nguyenchitu2005-jpg/KhoaBaoMat/docs/HuongDan_Slide_CongNghe_VanTay_KhuonMat.docx

# Hướng dẫn làm slide

Giới thiệu công nghệ chính của chức năng mở khoá bằng vân tay và khuôn mặt

Bản hướng dẫn này đi từ slide đầu tới slide cuối để giới thiệu 5 công nghệ chính làm nên hai chức năng mở khoá bằng vân tay và bằng khuôn mặt của khoá cửa thông minh. Mỗi slide gồm: mục đích, nội dung nên đưa lên, hình minh hoạ, lời nói gợi ý.

# Phần 1. Chuẩn bị trước khi làm slide

## 1.1. Năm công nghệ sẽ giới thiệu

Chức năng | Công nghệ | Vai trò trong dự án
Vân tay | Cảm biến vân tay quang học AS608 | Chụp ảnh, trích đặc trưng, lưu mẫu (tối đa 32) và so khớp ngay trong cảm biến
Vân tay | Adafruit Fingerprint Sensor Library 2.1.4 | Thư viện để ESP32 điều khiển AS608 qua UART
Khuôn mặt | Google ML Kit Face Detection | Tìm khuôn mặt và vị trí mắt; đo xác suất mắt mở để chống ảnh giả (bắt nháy mắt)
Khuôn mặt | Mô hình FaceNet-512 | Biến ảnh khuôn mặt thành vector 512 chiều để so khớp
Khuôn mặt | TensorFlow Lite | Chạy FaceNet-512 ngay trên điện thoại, không cần internet

## 1.2. Khung bài

- Tổng cộng 12 slide, khoảng 10–12 phút trình bày cộng 3–5 phút hỏi đáp.
- Thứ tự: mở đầu (3 slide) → nhóm vân tay (3 slide) → nhóm khuôn mặt (4 slide) → tổng kết và hỏi đáp (2 slide).
- Mỗi công nghệ trả lời đủ 3 câu: Nó là gì? Dùng để làm gì trong dự án? Hoạt động thế nào?

## 1.3. Quy tắc trình bày slide

- Mỗi slide một ý chính, tối đa 5–6 dòng chữ, cỡ chữ nội dung từ 24pt, tiêu đề từ 32pt.
- Dùng một mẫu (template) thống nhất cho cả bài: cùng phông chữ, cùng vị trí tiêu đề, cùng kiểu đánh số.
- Ưu tiên sơ đồ, lưu đồ, ảnh thật phần cứng và ảnh chụp màn hình app thay cho đoạn văn dài.
- Chữ trên slide là từ khoá; phần giải thích để trong lời nói (ghi vào phần Notes của slide).
- Ghi tên công nghệ đúng chính tả và đầy đủ ở lần nhắc đầu tiên, ví dụ "Google ML Kit Face Detection", các lần sau có thể gọi tắt "ML Kit".
- Đánh số trang cho mọi slide (trừ slide tiêu đề).

# Phần 2. Nội dung từng slide

### Nhóm mở đầu

## Slide 1. Tiêu đề

Mục đích: Giới thiệu đề tài và nhóm.

Nội dung đưa lên slide:

- Tên đề tài: Khoá cửa thông minh – mở khoá bằng vân tay và khuôn mặt
- Tên thành viên, lớp, giảng viên hướng dẫn
- Ngày trình bày

Hình minh hoạ: Một ảnh thật của khoá đã lắp hoàn chỉnh.

Lời thuyết trình gợi ý: "Nhóm em xin trình bày đề tài khoá cửa thông minh, tập trung vào các công nghệ giúp mở khoá bằng vân tay và bằng khuôn mặt."

## Slide 2. Mục tiêu và năm công nghệ chính

Mục đích: Cho người nghe thấy ngay toàn cảnh: hai chức năng, năm công nghệ.

Nội dung đưa lên slide:

- Mục tiêu: mở cửa bằng sinh trắc học, không cần chìa khoá
- Vân tay: cảm biến AS608 + thư viện Adafruit Fingerprint
- Khuôn mặt: Google ML Kit + FaceNet-512 + TensorFlow Lite

Hình minh hoạ: Bảng ở mục 1.1 rút gọn còn 2 cột: Công nghệ – Vai trò.

Lời thuyết trình gợi ý: "Để làm được hai chức năng này, nhóm dùng năm công nghệ: hai cho vân tay và ba cho khuôn mặt. Các slide sau sẽ giới thiệu lần lượt từng công nghệ."

## Slide 3. Công nghệ nằm ở đâu trong hệ thống

Mục đích: Chỉ rõ phần nào chạy trên khoá, phần nào chạy trên điện thoại.

Nội dung đưa lên slide:

- Trên khoá: ESP32 + cảm biến AS608 (thư viện Adafruit) → relay → chốt khoá
- Trên điện thoại: app Flutter dùng ML Kit, FaceNet-512, TensorFlow Lite
- Hai bên nói chuyện qua lệnh đã mã hoá

Hình minh hoạ: Sơ đồ khối 2 khung: "Khoá cửa" bên trái, "Điện thoại" bên phải, mũi tên lệnh mở ở giữa. Ghi tên từng công nghệ vào đúng khung.

Lời thuyết trình gợi ý: "Vân tay được xử lý ngay trên khoá. Khuôn mặt được xử lý trên điện thoại, khớp rồi điện thoại mới gửi lệnh mở cửa đã mã hoá cho khoá."

### Nhóm vân tay

## Slide 4. Cảm biến vân tay quang học AS608

Mục đích: Giới thiệu phần cứng nhận diện vân tay và nhấn mạnh việc nhận diện diễn ra ngay trong cảm biến.

Nội dung đưa lên slide:

- Là gì: mô-đun vân tay quang học có vi xử lý riêng
- Nguyên lý: đèn chiếu lên ngón tay đặt trên lăng kính, cảm biến ảnh chụp lại các đường vân
- Tự trích đặc trưng, lưu mẫu và so khớp bên trong mô-đun
- Trong dự án: lưu tối đa 32 vân tay; nối ESP32 qua UART 57.600 baud, nguồn 3,3V

Hình minh hoạ: Ảnh thật của mô-đun AS608 và một hình đơn giản minh hoạ ngón tay – lăng kính – camera.

Lời thuyết trình gợi ý: "AS608 không chỉ chụp ảnh vân tay. Bên trong nó có bộ xử lý riêng nên tự trích đặc trưng, tự lưu mẫu và tự so khớp. Mẫu vân tay vì vậy không bao giờ rời khỏi cảm biến."

Lưu ý: Số 32 là giới hạn do nhóm đặt trong dự án, không phải dung lượng tối đa của AS608.

## Slide 5. Thư viện Adafruit Fingerprint Sensor Library 2.1.4

Mục đích: Giải thích ESP32 "ra lệnh" cho cảm biến bằng cách nào.

Nội dung đưa lên slide:

- Là gì: thư viện mã nguồn mở của Adafruit cho Arduino/ESP32
- Chức năng: đóng gói giao thức UART của cảm biến thành các hàm dễ gọi
- Hàm chính: getImage (chụp), image2Tz (trích đặc trưng), createModel + storeModel (tạo và lưu mẫu), fingerSearch (tìm mẫu khớp), deleteModel (xoá)

Hình minh hoạ: Bảng 2 cột "Hàm – Ý nghĩa" như bảng bên dưới.

Lời thuyết trình gợi ý: "Nhờ thư viện Adafruit, ESP32 chỉ cần gọi vài hàm như chụp ảnh, trích đặc trưng, tìm mẫu; thư viện lo việc gửi và nhận gói tin với cảm biến qua cổng UART."

Hàm | Ý nghĩa | Dùng khi
getImage() | Chụp ảnh vân tay | Đăng ký và mở khoá
image2Tz() | Chuyển ảnh thành bộ đặc trưng | Đăng ký và mở khoá
createModel() | Ghép 2 lần chụp thành 1 mẫu | Đăng ký
storeModel(id) | Lưu mẫu vào vị trí ID | Đăng ký
fingerSearch() | Tìm mẫu khớp trong các mẫu đã lưu (1:N) | Mở khoá
deleteModel(id) | Xoá một mẫu | Xoá vân tay

## Slide 6. Vân tay hoạt động thế nào

Mục đích: Ghép hai công nghệ vân tay thành một quy trình hoàn chỉnh.

Nội dung đưa lên slide:

- Đăng ký: đặt tay lần 1 → nhấc tay → đặt tay lần 2 → ghép mẫu → lưu
- Mở khoá: cứ 300 ms kiểm tra → chụp → trích đặc trưng → tìm mẫu khớp
- Khớp: mở chốt 5 giây, ghi nhật ký; không khớp: đèn đỏ, còi báo

Hình minh hoạ: Hai lưu đồ ngắn đặt cạnh nhau: "Đăng ký" và "Mở khoá".

Lời thuyết trình gợi ý: "Khi đăng ký, ngón tay được chụp hai lần để mẫu ổn định. Khi mở khoá, cảm biến so ngón tay với mọi mẫu đã lưu; khớp là chốt mở trong 5 giây rồi tự khoá lại."

### Nhóm khuôn mặt

## Slide 7. Google ML Kit Face Detection

Mục đích: Giới thiệu công cụ phát hiện khuôn mặt và phân biệt rõ "phát hiện" với "nhận dạng".

Nội dung đưa lên slide:

- Là gì: bộ công cụ học máy của Google cho điện thoại, chạy ngay trên máy
- Chức năng: tìm khuôn mặt trong ảnh, vị trí hai mắt, góc quay đầu, xác suất mắt mở
- Dùng cho 2 việc: chống ảnh giả (bắt nháy mắt) và chuẩn bị ảnh mặt cho FaceNet
- ML Kit chỉ PHÁT HIỆN có khuôn mặt, không biết đó là ai

Hình minh hoạ: Ảnh chụp màn hình app lúc quét mặt, có khung quanh khuôn mặt; thêm 3 ô nhỏ "Mở mắt → Nháy mắt → Mở lại".

Lời thuyết trình gợi ý: "ML Kit giúp app biết trong ảnh có khuôn mặt nào, mắt ở đâu và mắt đang mở hay nhắm. Nhờ vậy app bắt người dùng nháy mắt, nên ảnh in hay ảnh trên màn hình không qua được. Việc nhận ra là ai sẽ do FaceNet đảm nhận."

Lưu ý: Ngưỡng chống ảnh giả: mắt mở khi xác suất trên 0,7, nhắm khi dưới 0,3.

## Slide 8. Mô hình FaceNet-512

Mục đích: Giải thích cách máy "nhận ra" một người.

Nội dung đưa lên slide:

- Là gì: mạng nơ-ron nhận dạng khuôn mặt (ý tưởng FaceNet do Google công bố năm 2015)
- Phiên bản dùng: Inception-ResNet-v1 huấn luyện trên bộ ảnh VGGFace2
- Chức năng: biến ảnh khuôn mặt 160×160 thành vector 512 con số
- Cùng một người → hai vector gần nhau; khác người → xa nhau
- So khớp: khoảng cách Euclid nhỏ hơn ngưỡng 0,65 thì coi là cùng người

Hình minh hoạ: Hình: ảnh khuôn mặt → hộp "FaceNet-512" → dãy số [0,12; −0,08; …] (512 số). Bên dưới vẽ hai chấm gần nhau (cùng người) và một chấm xa (người khác).

Lời thuyết trình gợi ý: "FaceNet biến mỗi khuôn mặt thành một "dấu vân tay số" gồm 512 con số. Khi đăng ký, app lưu dãy số này; khi mở cửa, app tạo dãy số mới và đo khoảng cách. Đủ gần thì là chủ nhà."

Lưu ý: Khi đăng ký, app lấy trung bình 5 ảnh; khi mở cửa, app chụp 2 ảnh và lấy ảnh khớp nhất.

Mức | Ngưỡng | Chính chủ được nhận | Người giống nhất lọt
Cơ bản | 0,75 | khoảng 96% | khoảng 1%
Cao (đang dùng) | 0,65 | khoảng 83% | khoảng 0,1%
Rất cao | 0,55 | khoảng 53% | khoảng 0,01%

Số liệu đo trên bộ ảnh LFW (bộ ảnh công khai, nhiều thời điểm và ánh sáng khác nhau). Nếu đưa bảng này lên slide, ghi rõ nguồn là số đo thử nghiệm.

## Slide 9. TensorFlow Lite

Mục đích: Giải thích vì sao mô hình nặng như FaceNet chạy được ngay trên điện thoại.

Nội dung đưa lên slide:

- Là gì: phiên bản gọn của TensorFlow (Google) để chạy mô hình AI trên điện thoại và thiết bị nhỏ (nay Google đổi tên là LiteRT)
- Chức năng trong dự án: chạy mô hình FaceNet-512 (tệp .tflite khoảng 24 MB) trên điện thoại
- Chạy trên 4 luồng CPU, không cần internet
- Lợi ích: nhanh, hoạt động khi mất mạng, ảnh khuôn mặt không rời khỏi điện thoại

Hình minh hoạ: Hình điện thoại có biểu tượng "không cần mạng", bên trong ghi "TensorFlow Lite → FaceNet-512".

Lời thuyết trình gợi ý: "FaceNet là mô hình lớn. TensorFlow Lite giúp chạy mô hình đó ngay trên điện thoại, nên app không phải gửi ảnh khuôn mặt lên máy chủ nào cả. Vừa nhanh vừa giữ được riêng tư."

## Slide 10. Khuôn mặt hoạt động thế nào

Mục đích: Ghép ba công nghệ khuôn mặt thành một quy trình từ camera tới cửa mở.

Nội dung đưa lên slide:

- Camera trước → ML Kit kiểm tra nháy mắt
- ML Kit tìm mặt → căn thẳng hai mắt, cắt và thu về 160×160
- TensorFlow Lite chạy FaceNet-512 → vector 512 chiều
- So với mẫu đã lưu → khớp thì gửi lệnh mở đã mã hoá → khoá mở 5 giây

Hình minh hoạ: Một dải mũi tên ngang 5 bước, mỗi bước ghi tên công nghệ phụ trách bên dưới.

Lời thuyết trình gợi ý: "Ba công nghệ phối hợp theo thứ tự: ML Kit lo chống giả và tìm khuôn mặt, TensorFlow Lite chạy FaceNet để tạo dãy số đặc trưng, rồi app so khớp. Khớp thì app mới gửi lệnh mở cửa."

### Nhóm tổng kết

## Slide 11. Tổng kết năm công nghệ

Mục đích: Nhắc lại toàn bộ trong một slide để người nghe dễ nhớ.

Nội dung đưa lên slide:

- Bảng 3 cột: Công nghệ – Vai trò – Chạy ở đâu
- Một dòng hạn chế: video quay sẵn có thể vượt bước nháy mắt; cảm biến quang học có thể bị vân tay giả

Hình minh hoạ: Bảng tổng kết như bên dưới.

Lời thuyết trình gợi ý: "Tóm lại, vân tay dựa vào AS608 và thư viện Adafruit, chạy hoàn toàn trên khoá. Khuôn mặt dựa vào ML Kit, FaceNet-512 và TensorFlow Lite, chạy hoàn toàn trên điện thoại."

Lưu ý: Chủ động nêu hạn chế ở đây trước khi bị hỏi; kèm hướng cải thiện (thử thách ngẫu nhiên như quay đầu, cảm biến vân tay điện dung).

Công nghệ | Vai trò | Chạy ở đâu
Cảm biến AS608 | Chụp, lưu mẫu, so khớp vân tay | Trên khoá
Adafruit Fingerprint Library | ESP32 điều khiển AS608 | Trên khoá (ESP32)
Google ML Kit Face Detection | Tìm mặt, chống ảnh giả | Trên điện thoại
FaceNet-512 | Tạo vector 512 chiều để nhận ra người | Trên điện thoại
TensorFlow Lite | Chạy FaceNet-512 không cần mạng | Trên điện thoại

## Slide 12. Demo và hỏi đáp

Mục đích: Chứng minh bằng thực tế và mời đặt câu hỏi.

Nội dung đưa lên slide:

- Demo: mở bằng vân tay → vân tay lạ bị từ chối → mở bằng khuôn mặt → ảnh in bị chặn
- Cảm ơn và mời đặt câu hỏi

Hình minh hoạ: Chữ "Demo" lớn; chuẩn bị sẵn video dự phòng nếu demo trục trặc.

Lời thuyết trình gợi ý: "Bây giờ nhóm xin demo trực tiếp hai chức năng vừa trình bày."

# Phần 3. Câu hỏi thường gặp về các công nghệ

### ML Kit và FaceNet khác nhau thế nào?

ML Kit chỉ phát hiện có khuôn mặt, vị trí mắt và mắt đang mở hay nhắm. FaceNet mới là phần nhận ra khuôn mặt đó là của ai, bằng cách tạo vector 512 chiều để so khớp.

### Tại sao không chạy nhận diện khuôn mặt trên ESP32?

Mô hình FaceNet-512 nặng khoảng 24 MB và cần nhiều sức tính, vượt khả năng của ESP32. Chạy bằng TensorFlow Lite trên điện thoại nhanh hơn và ảnh không phải gửi đi đâu.

### Mẫu vân tay và mẫu khuôn mặt lưu ở đâu?

Mẫu vân tay lưu trong bộ nhớ của cảm biến AS608. Mẫu khuôn mặt là một vector 512 số, lưu mã hoá trong kho bảo mật của điện thoại; app không lưu ảnh.

### Vì sao chọn thư viện Adafruit?

Đây là thư viện mã nguồn mở phổ biến, hỗ trợ sẵn giao thức của AS608 và dòng cảm biến cùng loại, có đủ hàm đăng ký, tìm, xoá mẫu nên không phải tự viết giao thức UART.

### Ảnh in hoặc video có qua mặt được không?

Ảnh tĩnh bị chặn vì phải nháy mắt (ML Kit đo mắt mở/nhắm). Video quay sẵn có thể vượt qua; đây là hạn chế, hướng cải thiện là yêu cầu thao tác ngẫu nhiên hoặc dùng camera đo chiều sâu.

# Phần 4. Kiểm tra lần cuối trước khi trình bày

1. Đủ 12 slide, có số trang, tên công nghệ viết đúng và đầy đủ ở lần đầu.
2. Mỗi công nghệ đã trả lời đủ: là gì, làm gì trong dự án, hoạt động thế nào.
3. Có sơ đồ ở slide 3, lưu đồ ở slide 6, dải quy trình ở slide 10.
4. Bảng ngưỡng (nếu dùng) có ghi nguồn số liệu.
5. Lời nói của từng slide đã ghi vào Notes; tập nói đủ thời gian ít nhất một lần.
6. Khoá, điện thoại, ảnh in để demo đã sẵn sàng; có video dự phòng.
