nguyenchitu2005-jpg/KhoaBaoMat/(commit log)

2026-10-12 Khoá thông minh ESP32 + app Flutter: giai đoạn 1-2, bắt đầu giai đoạn 3
    - Firmware smart_lock: BLE, AES-256-GCM challenge-response, ghép đôi X25519 + mã 6 số
    - Thêm access_store.h / access_log.h (thẻ, vân tay, PIN, nhật ký) cho giai đoạn 3
    - Các sketch kiểm tra phần cứng (RFID, bàn phím, vân tay, nút, tổng hợp)
    - App Flutter: quét, kết nối, ghép đôi, mở khoá bằng sinh trắc học
    - Tài liệu: sơ đồ nối dây, kiến trúc app, tiến độ
2026-10-12 feat: giai đoạn 3 - thẻ RFID, vân tay, PIN, nhật ký và trang quản lý
    Firmware: mở khoá bằng thẻ RC522, vân tay AS608, mã PIN trên bàn phím
    (sai 5 lần thì khoá bàn phím 5 phút), ghi nhật ký LittleFS, lệnh quản lý
    chỉ dành cho admin (đăng ký/xoá thẻ và vân tay, đặt PIN, liệt kê, đọc
    nhật ký). Giữ nút 15 giây giờ xoá cả thẻ, vân tay và PIN.
    App: SecureCommandSender.send có timeout, thêm AccessAdmin, trang Quản lý
    truy cập và trang Nhật ký (chỉ hiện với admin, phải qua sinh trắc học).
    Đã test trên khoá thật: ghép đôi, PIN, vân tay, thẻ. Chưa thử: sai PIN,
    nhật ký, xoá thẻ/vâ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
2026-10-13 feat: mã khách có hạn, xem và thu hồi điện thoại đã ghép đôi
    - Firmware: CMD_SET_GUEST_PIN (PIN thứ hai có hạn, tự xoá khi quá hạn),
    CMD_LIST_PHONES, CMD_REVOKE_PHONE (không cho tự thu hồi chính mình).
    - LIST_ACCESS thêm 4 byte hạn mã khách.
    - App: đặt/xoá mã khách, danh sách điện thoại và thu hồi trong trang quản lý.
    - Nhật ký phân biệt mở bằng mã khách với mã PIN.
2026-10-13 feat: nút trong nhà bật/tắt một nhịp, tự khoá sau BUTTON_OPEN_MS
    Bấm khi đang khoá thì mở và giữ tối đa 30 giây, bấm lần nữa thì khoá ngay.
    Thẻ, vân tay, PIN và app vẫn tự khoá sau UNLOCK_MS (5 giây).
    Đã biên dịch, chưa nạp thử trên khoá thật.
2026-10-14 feat: mở khoá bằng khuôn mặt, điều khiển qua Wi-Fi trong nhà và từ xa (MQTT)
    Firmware
    - Nút trong nhà bật/tắt một nhịp (tối đa TOGGLE_OPEN_MS = 30 giây); thẻ, vân tay,
    PIN, app mở UNLOCK_MS = 5 giây rồi tự khoá.
    - Wi-Fi: CMD_SET_WIFI / CMD_WIFI_STATUS, lưu NVS, tự kết nối lại, giờ chuẩn NTP.
    - LAN: TCP cổng 4545 (gói [độ dài 2B][gói như BLE]), UDP tìm khoá "KBM?"/"KBM!".
    - Từ xa: esp-mqtt qua TLS (CMD_SET_MQTT / CMD_MQTT_STATUS), chủ đề
    khoabaomat/<địa chỉ BLE>/c|e|s, cờ online/offline giữ lại trên máy chủ, nhật ký
    LOG_REMOTE; không cho đổi Wi-Fi / máy chủ qua chính đường từ xa.
    - M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
2026-10-15 docs: README hướng dẫn cài đặt, sử dụng và kèm APK
    - Viết lại README: tính năng, phần cứng và lưu ý nối dây, cài firmware
    (lõi ESP32 3.3.12, MFRC522 1.4.12, Adafruit Fingerprint 2.1.4,
    NimBLE-Arduino 2.5.1, huge_app), cài app, hướng dẫn sử dụng, xử lý sự cố
    - Thêm release/Khoabaomat.apk (bản release arm64, 89 MB; bản đủ ABI 125 MB
    vượt giới hạn 100 MB của GitHub)
2026-10-15 docs: link tải APK trực tiếp và hướng dẫn khi không cài được app
    - Link APK thêm ?raw=true để tải đúng file thay vì trang xem file của GitHub
    - Bảng lỗi cài đặt: trùng gói khác chữ ký, tải nhầm trang HTML, bị chặn
    cài đặt trên OPPO/Xiaomi, máy 32-bit
2026-10-16 fix: RC522 tự khởi tạo lại khi bị reset do sụt áp; thêm log chẩn đoán và tài liệu thuyết trình
    - Kiểm tra RC522 mỗi 2 giây (RFID_CHECK_MS): ngoài VersionReg còn đọc TxControlReg,
    TModeReg, TxASKReg. RC522 bị sụt áp sẽ tự reset (ăng-ten tắt, cấu hình về mặc định)
    trong khi VersionReg vẫn đọc được, nên trước đây đầu đọc "chết" tới khi cắm lại nguồn.
    Giờ phát hiện lệch cấu hình thì gọi PCD_Init và ghi log số lần reset.
    - Log mỗi lệnh nhận được kèm đường truyền (BLE / Wi-Fi trong nhà / máy chủ trung gian).
    - Dòng trạng thái mỗi 30 giây (STATUS_LOG_M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
